bakathefish/GPU/README.md

## goobeywoobey GPU- a doohickey engineering project  

**~3 Mpix/s hardware fill · double-buffered VRAM · built from jellybean 74HC chips + 62256 SRAM on a 30×40 cm perfboard.**

Host ESP32 issues draw commands. The output ESP32 scans the frame out. Everything in between, which includes but is not limited to
address generation, write engine, VRAM, bus arbitration, double buffering, is done by 
discrete logic. No microcontroller touches a pixel between command and scanout.

```
                                THE GPU (discrete logic)
             ┌─────────────────────────────────────────────────────────┐
 ESP32 #1    │  ┌─────────┐    ┌──────────────┐    ┌───────┐            │    ESP32 #2
 "HOST"      │  │ 3× 595  │──▶│ 4× HC163      │──▶│2× 541 │─┐          │    "SCANOUT"
 draw cmds ──┼─▶│ cmd regs│   │ 16-bit fill   │   │ (fill │ │ ADDR     │
 SPI 10 MHz  │  │ AH AL PX│    │ addr counter  │   │  side)│ │ BUS      │  ┌─────────┐
             │  └────┬────┘    │ loadable,     │   └───────┘ ├──▶┌────┐ │  │ browser │
 CP bursts ──┼─▶ WE gating───▶│ auto-increment│             │   │VRAM│ │  │ viewer  │
 (~3 MHz,    │   (74HC32/04)   └──────────────┘   ┌───────┐  │   │ A  │ │  │ over    │
  1 clk =    │                                    │2× 541 │  │   │────│ │  │ WiFi AP │
  1 pixel)   │        ┌──────────────┐            │ (scan │──┘   │VRAM│ │  └─────────┘
             │        │ 2× HC393     │───────────▶│  side)│     │ B  │ │       ▲
             │        │ 15-bit scan  │            └───────┘      └──┬─┘ │       │
 pixel clk ◀─┼────────│ addr counter │◀── SCANCLK ──────────────────┼───┼── 8-bit parallel
             │        └──────────────┘            74HC74 swap FF ───┘  │   read @ ~1.5 MHz
             └─────────────────────────────────────────────────────────┘
```

## how does it work?

### Fill engine (the main part ig)
1. Host shifts 24 bits over SPI into the 595 chain: `[PIXEL][ADDR_LO][ADDR_HI]`,
   pulses RCLK.
2. Host pulls `/PE` low, pulses CP once → the HC163 chain **parallel-loads** the
   start address.
3. Host raises `FILL_EN`:
   - fill-side 541s drive the address bus, scan-side 541s go Hi-Z,
   - the PIXEL 595 drives the data bus, SRAM `/OE` is forced high,
   - `/WE = CP OR /FILL_EN` → every CP low phase is a write strobe.
4. Host streams **N bare clock pulses** (tight IRAM loop, ~3 MHz). Each pulse:
   CP low → write pixel at current address; CP rising edge → write commits **and**
   the counter increments. **One pulse = one pixel.** The address rolls across row
   boundaries, so a full-screen clear is a single 20480-pulse burst (~7 ms).
5. Host drops `FILL_EN` → bus returns to the scan side.

## why this goes vroom vroom fast:
a CPU writing through shift registers pays 24+ SPI bits + latch +
strobe per pixel (~4 µs). The fill engine pays that **once per run**, then 1 clock
per pixel. Measured speedup on full-screen clears: **>10×** (the demo firmware
benchmarks it live).

### Scan-out thingy
- The HC393 ripple chain generates sequential addresses 0..20479. ESP32 #2 pulses
  `SCAN_RST`, then clocks `SCANCLK` (~1.4 MHz) and reads the SRAM data bus directly
  on 8 GPIOs which is one full byte per clock.
  
### Arbitration / vsync (2 wires thingy between the ESP32s)
- `BUSY` (host → scanout): high while the host owns the GPU bus. Scanout never
  starts a frame while BUSY.
- `FRAME_ACT` (scanout → host): high during a frame capture. Host waits for it to
  drop before drawing. Result: no torn frames even in single-buffer mode.

## instructions

1. buy all the components
2. follow the instructions from netlist.md and instructions-buildplan.md
3. pray and hope

## schematic


### double buffering (stage 2)
Both SRAMs share the address/data bus. A 74HC74 flip-flop (`SEL`) steers `/WE` to
the back buffer and `/OE` to the front buffer through four OR gates ('32):

| signal | equation | effect |
|---|---|---|
| `/WE_A` | `/WE_F OR SEL` | A written only when SEL=0 |
| `/WE_B` | `/WE_F OR /SEL` | B written only when SEL=1 |
| `/OE_A` | `FILL_EN OR /SEL` | A scanned only when SEL=1 |
| `/OE_B` | `FILL_EN OR SEL` | B scanned only when SEL=0 |

Host toggles SEL with one `SWAP` pulse between frames. Draw time is hidden: the
viewer always sees a complete frame while the next one is drawn.

## cool number tested by maths that should theorteically work that go vroom

| Spec | Value |
|---|---|
| Resolution / color | 160×128, 8 bpp RGB332 |
| VRAM | 2× 32 KB SRAM, double buffered (20 KB/frame + 12 KB spare each) |
| Fill rate | ~3 Mpix/s burst (1 pixel/clock), tunable to 5 MHz |
| Scan-out | 8-bit parallel, ~65 fps capture, ST7735 TFT + WiFi browser |
| Logic | 19 ICs: 595/163/393/541/32/04/74 + 62256 |
| Clocks | Fully static design|
| Big H haul | sprite blitter (HC245 + 3rd counter), register file (7× HC574), autonomous 25 MHz clock domain (crystals + HC04), HW cursor blink (HC123) |

## Pitch framing
- The ESP32s are *peripherals*: one is the "driver/command generator", one is the
  "monitor cable". The GPU itself does address generation, write sequencing, VRAM,
  bus arbitration, buffer steering is a 74-series logic you can point at.

## Oscilloscope reading
Here are readings from the oscilliscope to prove it works: 





## Zine
[zine.pdf](https://github.com/user-attachments/files/29722720/zine.pdf)
