bakathefish/GPU/firmware/SCH_Schematic1_1-P1_2026-07-06.png

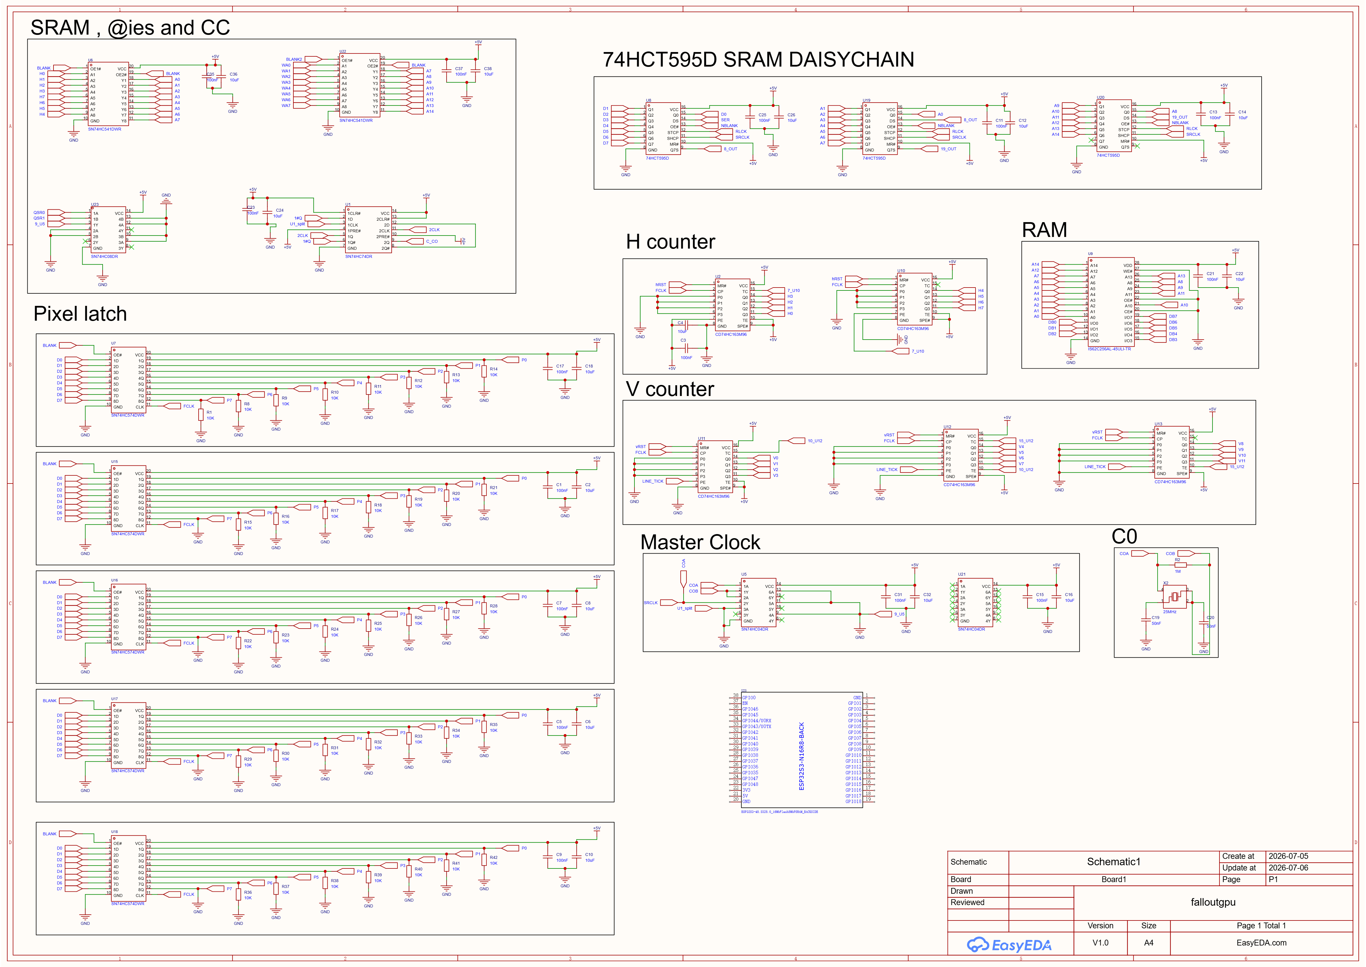
firmware/SCH_Schematic1_1-P1_2026-07-06.png
