bakathefish/GPU/(list of files, drawings)

Other design files:
schematic/goobeywoobey.epro
