bakathefish/GPU/(commit log)

2026-07-06 making changes
    [Components.xlsx, goobeywoobey.epro]
2026-07-06 file upload
    [continuous.cfg, license-checker.cfg, presubmit.cfg, pyktx.ktx_astc_params.rst.txt, pyktx.ktx_basis_params.rst.txt]
